GedaliaR/EtchABot/STL/Motor Sleeve.stl

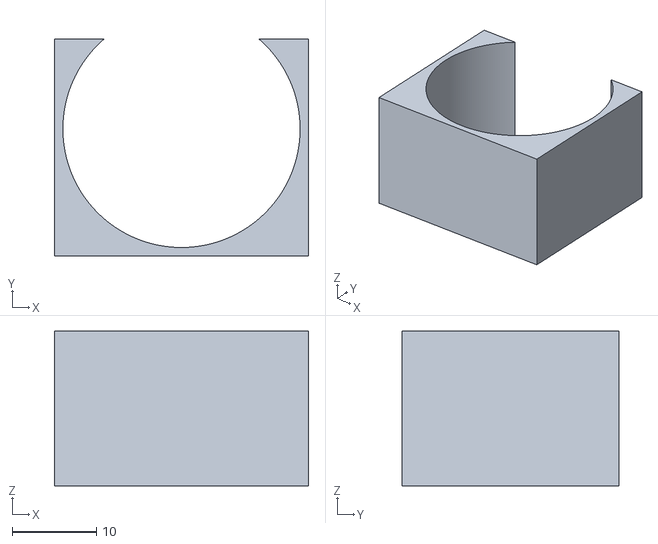
[picture p10: CAD file, 2020-05-26]
STL/Motor Sleeve.stl
30.2 x 25.8 x 18.4
