GedaliaR/EtchABot/STL/Gear Knobs Involute.stl

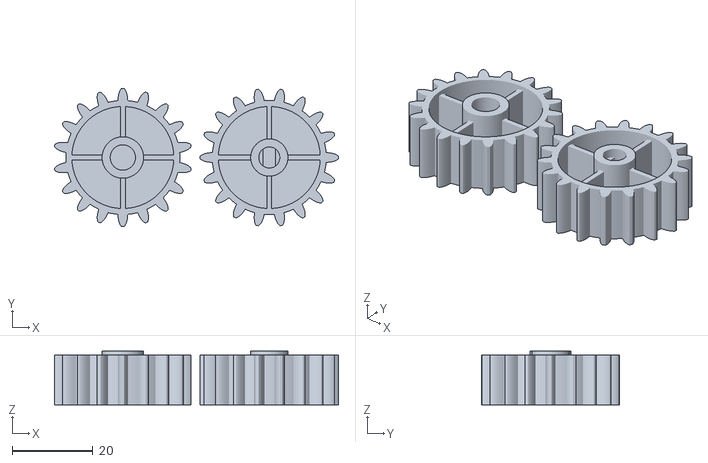
[picture p11: CAD file, 2020-05-26]
STL/Gear Knobs Involute.stl
70.2 x 34.2 x 13.3
