GedaliaR/EtchABot/STL/Gear Knobs Square.stl

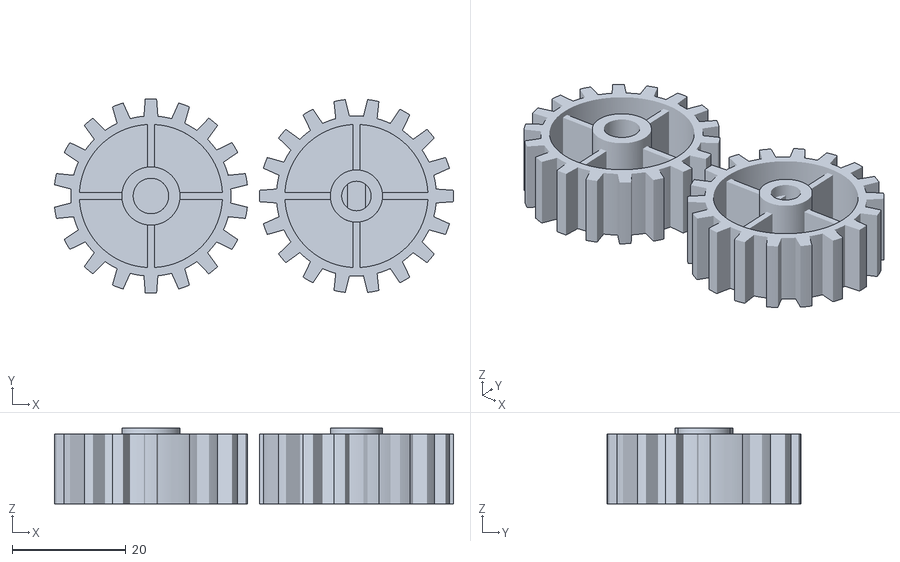
[picture p12: CAD file, 2020-05-26]
STL/Gear Knobs Square.stl
70.3 x 34.2 x 13.3
