GedaliaR/EtchABot/(list of files, drawings)

Other design files:
images/etchabot.fzz
